Sussex-Neuroscience/screens-behavioural-box/README.md

# Screens behavioural box

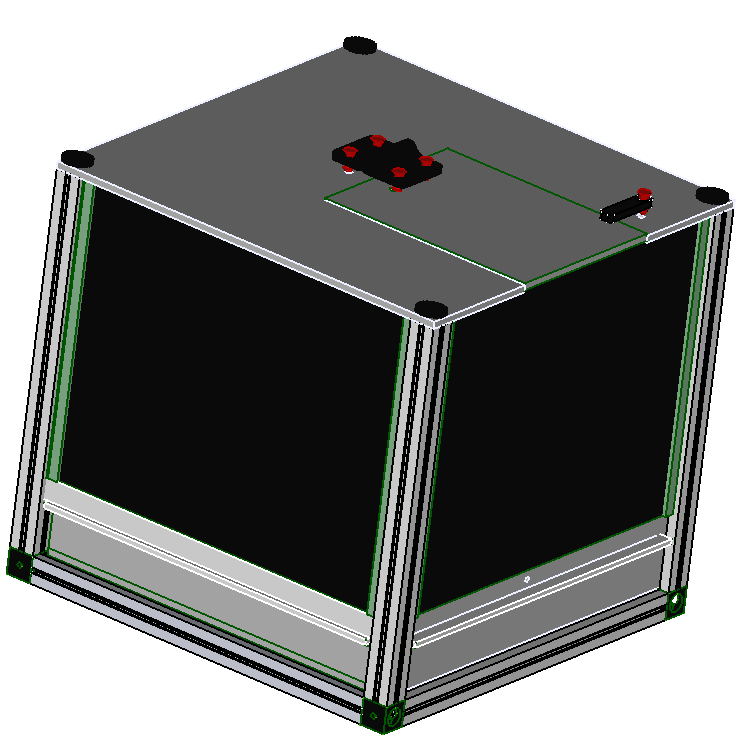
[picture p1: documentation/images/Final.PNG]


The box is used to research on mice reaction to different scenes played on the screens inside the box.

It uses an impliemtation of the beehive to check on the feeding of the mice.
