Sussex-Neuroscience/screens-behavioural-box/documentation/index.md

# Screens behavioural box



Free moving rodents complete viual field stimulation using touch screens.

It uses an impliemtation of the beehive to check on the feeding of the mice.

You should link to a couple of pages:

* [.](testpage1.md){step}
* [.](testpage2.md){step}

And you should definitely let people know about the [bill of materials]{BOM} page.
