Sussex-Neuroscience/screens-behavioural-box/documentation/Screens_behavioural_box.PNG

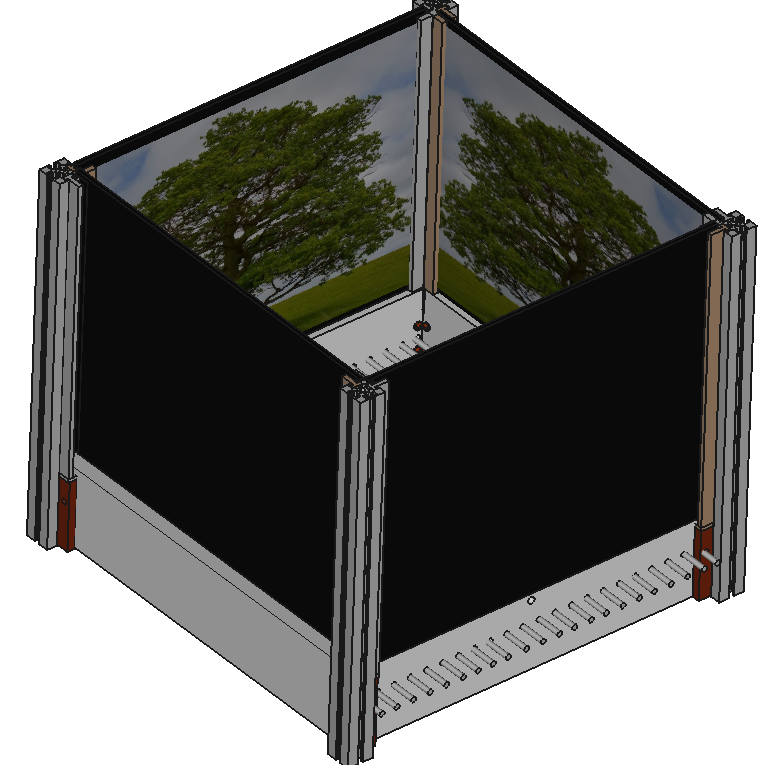
documentation/Screens_behavioural_box.PNG
