Sussex-Neuroscience/screens-behavioural-box/hardware/3mm_Aluminium_rod.FCStd

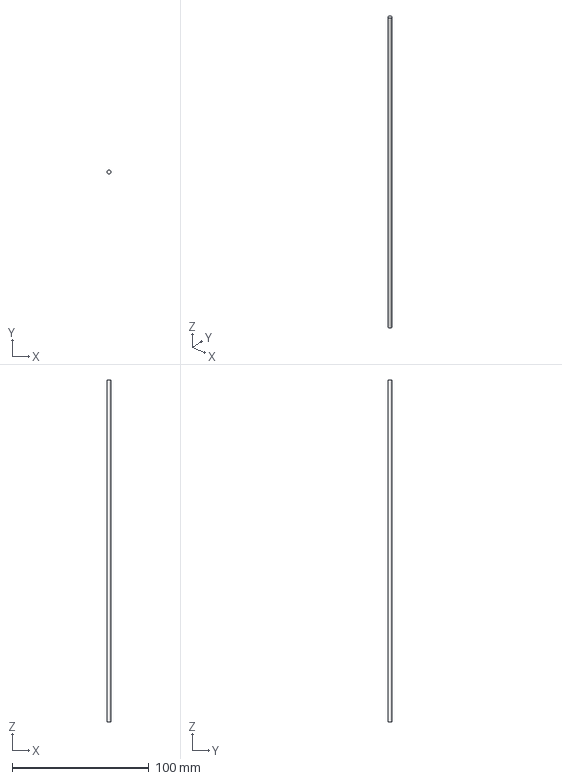
[picture p4: CAD file, 2024-06-05]
hardware/3mm_Aluminium_rod.FCStd
3.10 x 3.10 x 250.0 mm
