Sussex-Neuroscience/screens-behavioural-box/hardware/models/Screens_behavioural_box.FCStd

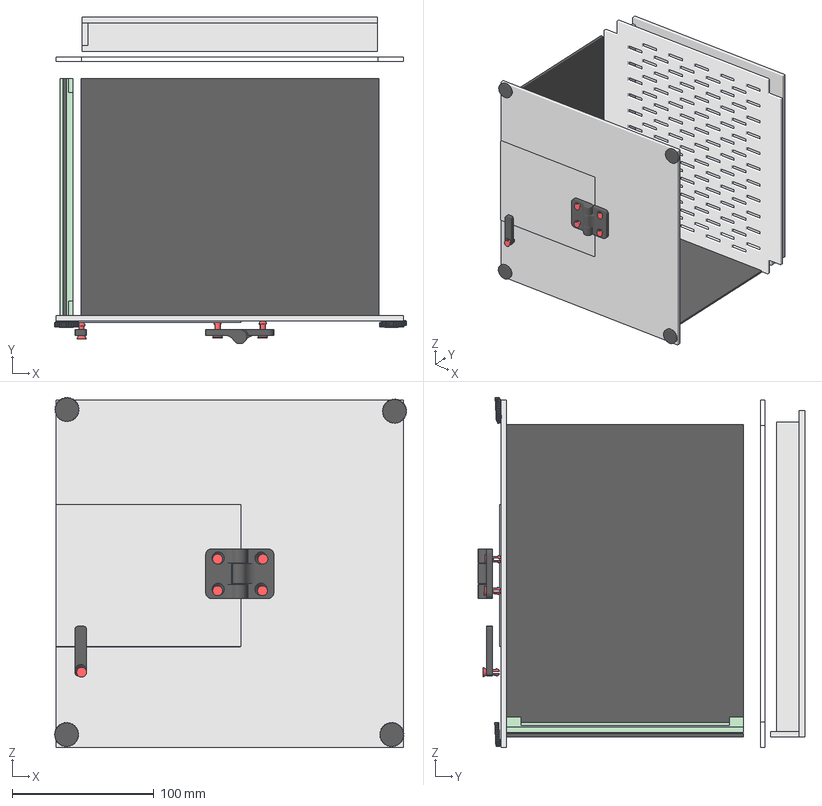
[picture p5: CAD file, 2024-08-22]
hardware/models/Screens_behavioural_box.FCStd
247.9 x 230.0 x 246.7 mm
Latch
Base
Excrete_bottom
Excretion_sides
Lid
Hinge_pin
Door
Hinge_pin001
Hinge_pin002
Hinge_pin003
Hinge_pin004
print-in-place-hinge
Thumb_wheel
Thumb_wheel001
Thumb_wheel002
Thumb_wheel003
