Sussex-Neuroscience/screens-behavioural-box/hardware/grid_bottom.stl

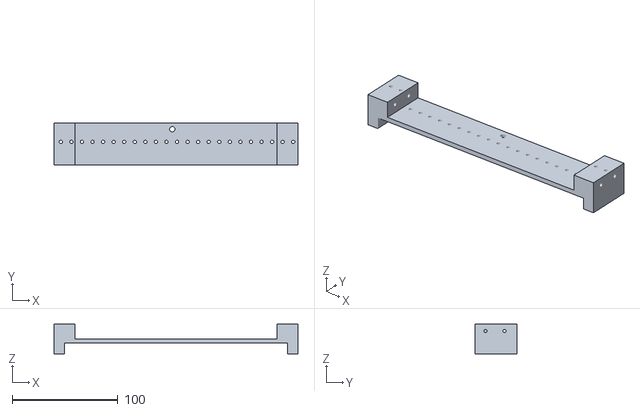
[picture p6: CAD file, 2024-05-12]
hardware/grid_bottom.stl
231.0 x 40.0 x 28.0
