Sussex-Neuroscience/screens-behavioural-box/hardware/models/Thumb_wheel.stl

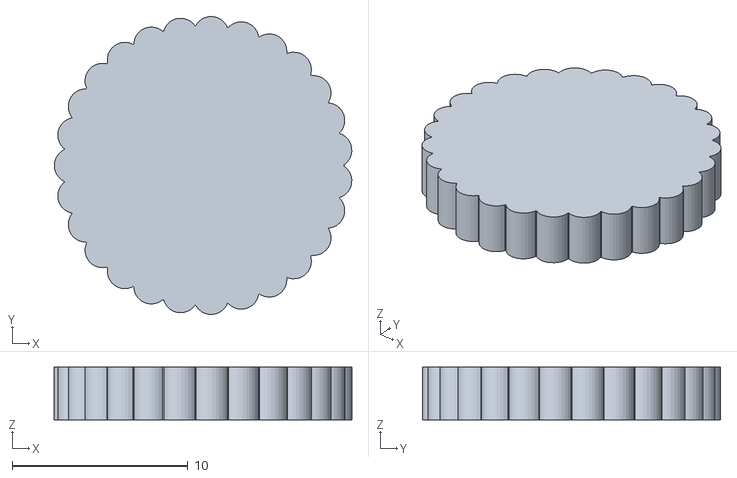
[picture p7: CAD file, 2024-07-31]
hardware/models/Thumb_wheel.stl
16.9 x 17.0 x 3.00
