Sussex-Neuroscience/screens-behavioural-box/hardware/models/Screen_support.stl

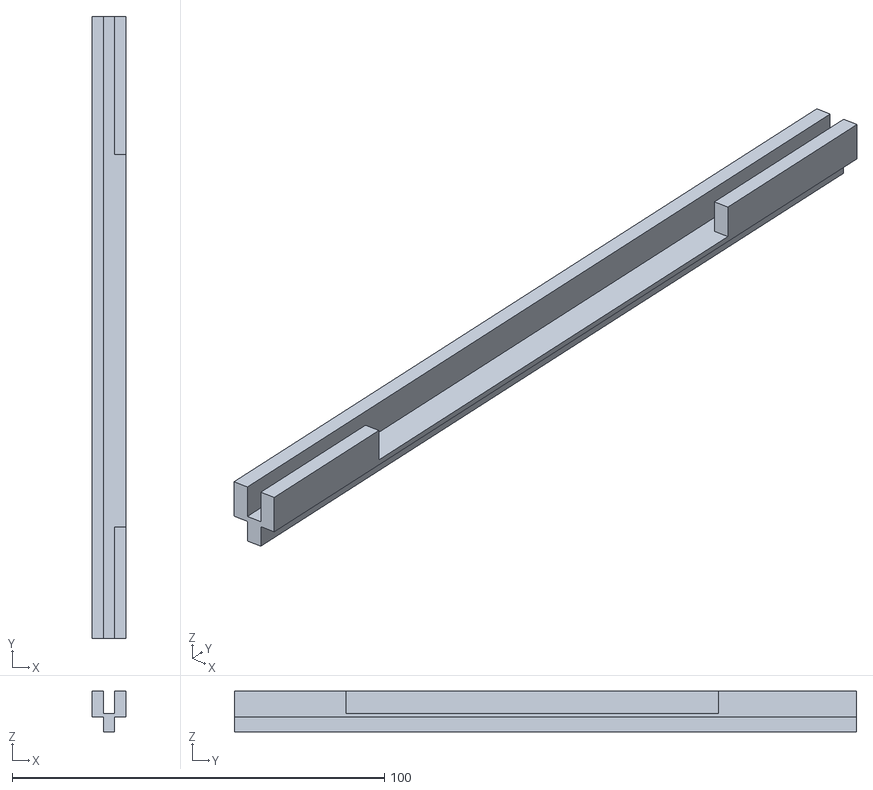
[picture p8: CAD file, 2024-07-31]
hardware/models/Screen_support.stl
9.00 x 167.0 x 11.0
