Sussex-Neuroscience/screens-behavioural-box/hardware/side_cover.stl

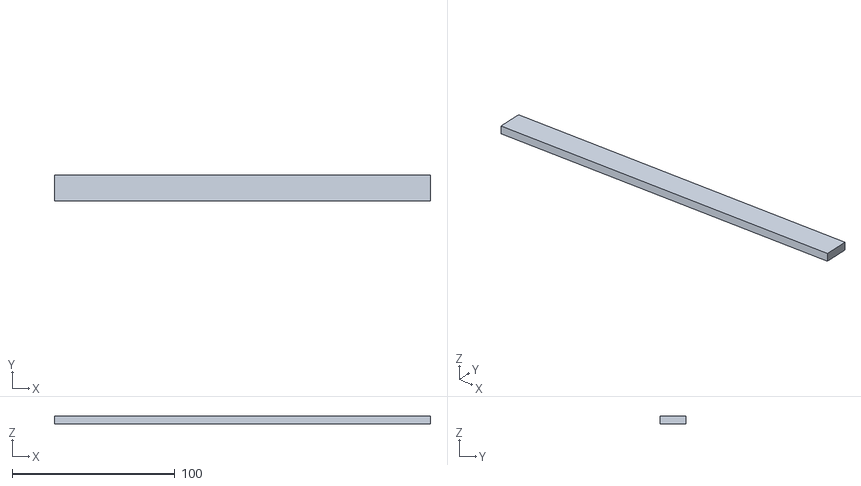
[picture p9: CAD file, 2024-05-12]
hardware/side_cover.stl
231.0 x 15.9 x 5.00
