Sussex-Neuroscience/screens-behavioural-box/hardware/models/Latch.stl

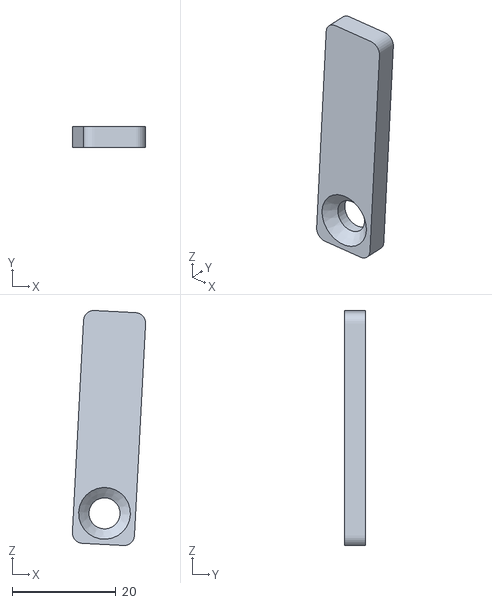
[picture p10: CAD file, 2024-07-31]
hardware/models/Latch.stl
14.1 x 4.00 x 45.4
