Sussex-Neuroscience/screens-behavioural-box/hardware/screen_holder.FCStd

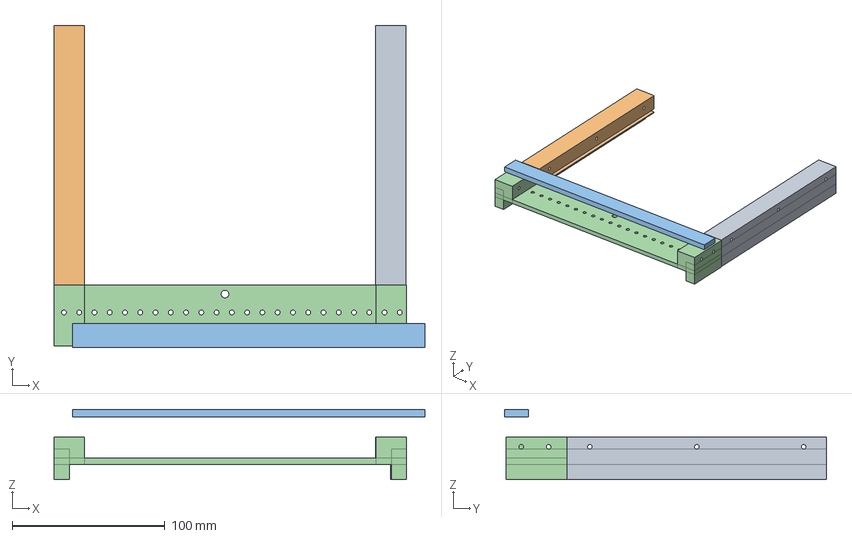
[picture p11: CAD file, 2024-05-12]
hardware/screen_holder.FCStd
243.0 x 211.0 x 46.0 mm
screenHolder (Mirror #1)
screenHolder001
side_cover
grid_bottom
