Sussex-Neuroscience/screens-behavioural-box/hardware/models/Groove_pin.stl

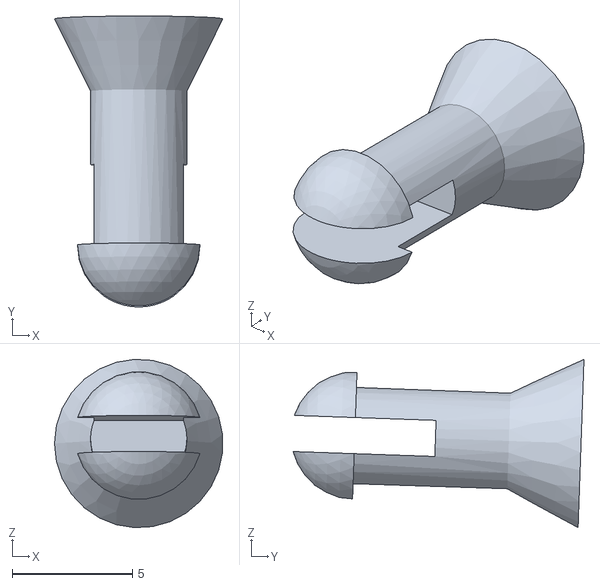
[picture p12: CAD file, 2024-07-31]
hardware/models/Groove_pin.stl
6.98 x 12.1 x 6.99
