Sussex-Neuroscience/screens-behavioural-box/hardware/screen_holder_mirrored.stl

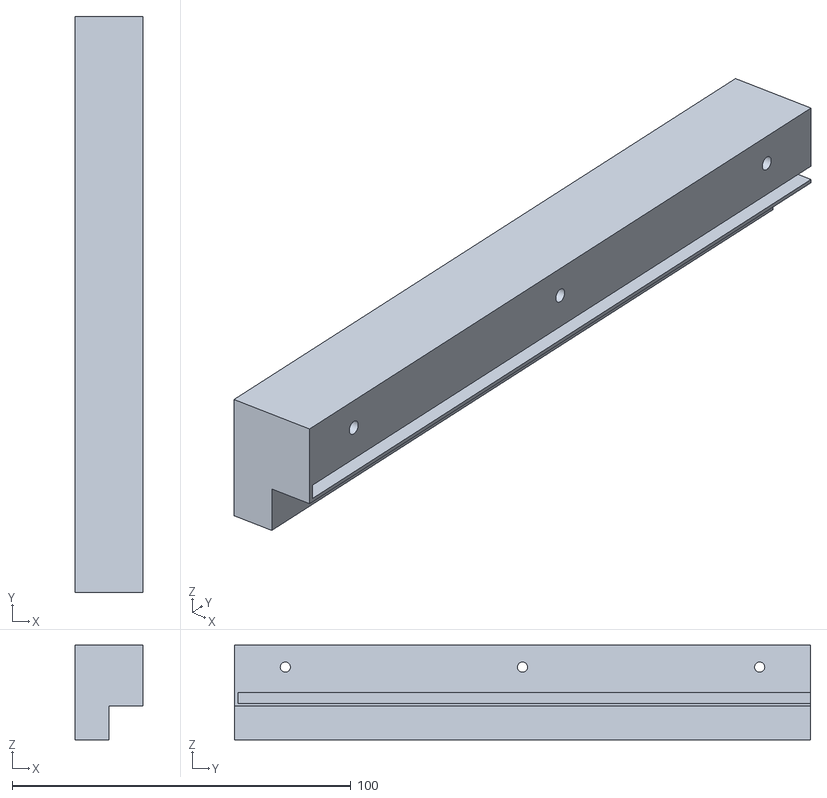
[picture p13: CAD file, 2024-05-12]
hardware/screen_holder_mirrored.stl
20.0 x 170.0 x 28.0
