Sussex-Neuroscience/screens-behavioural-box/hardware/models/Corners.step

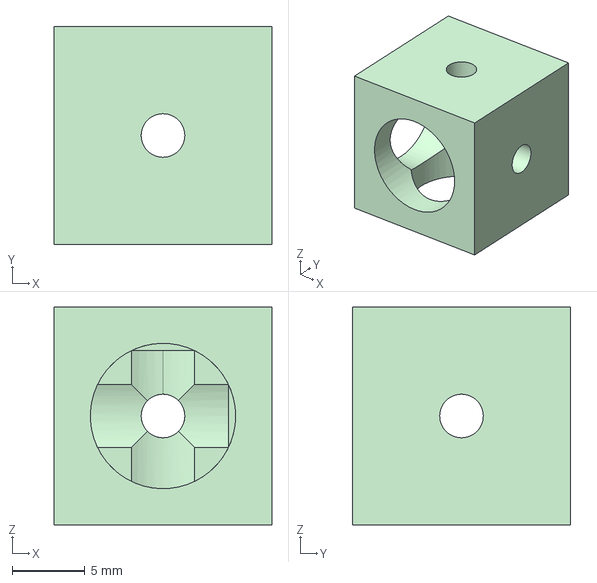
[picture p14: CAD file, 2024-07-31]
hardware/models/Corners.step
15.0 x 15.0 x 15.0 mm
