Sussex-Neuroscience/screens-behavioural-box/hardware/grid_template.stl

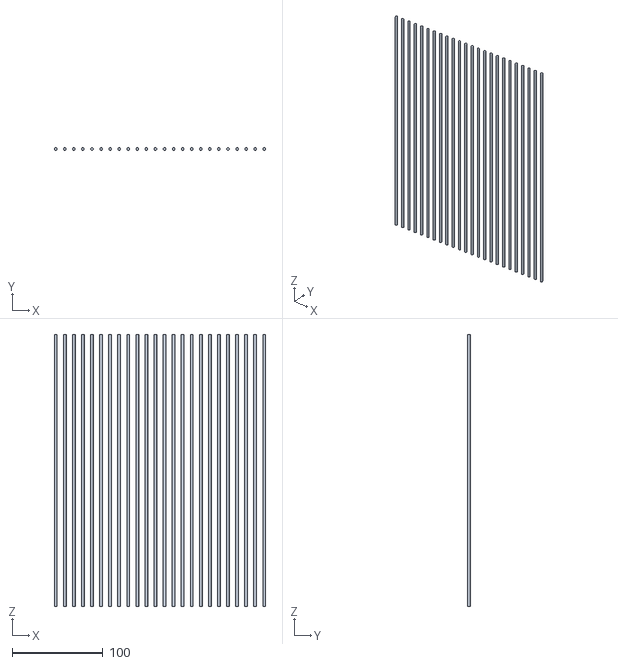
[picture p15: CAD file, 2023-11-29]
hardware/grid_template.stl
233.2 x 2.77 x 300.0
