Sussex-Neuroscience/screens-behavioural-box/(list of files, cad)

Other CAD files:
hardware/all_parts_P1S_printer.gcode.3mf
hardware/archive/all_parts_P1S_printer.gcode.3mf
hardware/models/Charlies_designs/Syringe Holder Model rev5.scad
hardware/archive/grid_with_support.scad
hardware/archive/screen_holder.stl
hardware/grid_with_support.scad
hardware/screen_holder.stl
