Sussex-Neuroscience/screens-behavioural-box/documentation/Parts.yaml

---
MakerBeamXL:
  Name: maker beam XL
  Description: >
    A single length of black anodised MakerBeamXL which has a 15mm x
    15mm square profile
  Suppliers:
    technobotsonline:
      PartNo: 4447-087
      Link: https://www.technobotsonline.com/makerbeamxl-1000mm-long-black-anodised-beam-threaded.html
Hacksaw:
  Name: 150mm mini hacksaw
  Description: >
    The Bahco Junior Hacksaws, featuring a steel frame and a fibreglass
    handle,  come with a practical and simple blade tensioning device.  The
    blade tensioning is easily achieved through a simple screw operation.
  Suppliers:
    RS:
      PartNo: 281-9162
      Link: https://uk.rs-online.com/web/p/hand-saws/2819162?gb=a
ClearSheet:
  Name: clear plastic sheet
  Description: >
    The polyethylene terephthalate glycol (PETG) sheet is both
    versatile and durable.  It can withstand high-impact knocks and drops, even
    at extremely low temperatures. resistant to chemicals and has a UL 94
    flammability rating, so it will  self-extinguish in the event of a fire.
  Suppliers:
    RS:
      PartNo: 334-6472
      Link: https://uk.rs-online.com/web/p/plastic-sheets/3346472?gb=s
M3X8mmSocketcap:
  Name: M3x8 socket cap screw
  Description: >
    Socket screws are a type of threaded bolt which screws into an
    appropriate socket,  and are used to fasten various materials
    together.  They are designed to be turned by hex keys or similar tools.
  Specs:
    Head: Hex Socket Cap
    Length: 8 mm
    Material: Stainless Steel
    Pitch: 0.5 mm
  Suppliers:
    RS:
      PartNo: 280-997
      Link: https://uk.rs-online.com/web/p/socket-screws/0280997?gb=s
2mmHexkey:
  Name: 2mm Hex key
  Description: >
    T handle tool is designed for very high torque speeds and offers an
    easy,  fantastic solution for loosening and tightening screws.
  Specs:
    Head: Hex key
    size: 2 mm
    Material: Chrome Vanadium Steel
    Arm: long
  Suppliers:
    RS:
      PartNo: 707-3282
      Link: https://uk.rs-online.com/web/p/hex-keys/7073282?gb=s
Tapwrench:
  Name: tap wrench
  Description: >
    Tap wrenches are a type of hand tool designed to tap internal
    thread tools with ease.  They are often equipped with adjustable jaws that
    secure to the fitting and handles  that allow the user to turn the tool with
    ease.
  Specs:
    Type: T-Handle Tap Wrench
    Material: Steel
    Thread size: M1.5 to M4
  Suppliers:
    RS:
      PartNo: 230-0112
      Link: https://uk.rs-online.com/web/p/tap-die-wrenches/2300112?gb=a
M3tapset:
  Name: M3 tap set
  Description: >
    Used for thread cutting in holes into various materials such as
    steel allowing you to create  a smooth and precise thread for bolts and
    other materials. 
  Specs:
    Type: Threading Tap Set
    Material: HSS
    Thread size: M3
  Suppliers:
    RS:
      PartNo: 215-552
      Link: https://uk.rs-online.com/web/p/threading-taps/0215552?gb=s
Lasercutter:
  Name: Laser cutter
  Description: |
    Glowforge 
  Specs:
    Technology: 45w laser
    Model: Glowforge PRO
    Dimensions: 38” (W) x 20 3/4” (D) x 8 1/4” (H)
  Suppliers:
    RS:
      PartNo: ENDER-3 S1 PRO
      Link: https://uk.rs-online.com/web/p/3d-printers/2857472?gb=s
3dprinter:
  Name: 3d printer
  Description: |
    CREALITY ENDER-3 S1 PRO 3D Printer Kit.
  Specs:
    Technology: FFF
    Build volume: 220x220x270
    Model: ENDER-3 S1 PRO
    Dimensions: 455 x 490 x 625mm
  Suppliers:
    RS:
      PartNo: ENDER-3 S1 PRO
      Link: https://uk.rs-online.com/web/p/3d-printers/2857472?gb=s
Display:
  Name: 3/4 retina display
  Description: |
    LG LP097QX1 - iPad 3/4 Retina Display
  Specs:
    Resolution: 2048x1536
    Size: 206mm x 165mm / 8.1" x 6.5"
    Weight: 130g
  Suppliers:
    RS:
      PartNo: 1751
      Link: https://www.adafruit.com/product/1751#technical-details
Displaydriver:
  Name: Display driver
  Description: |
    Qualia Bare Driver Board for LP097QX1 Display
  Specs:
    Dimensions: 45mm x 85mm / 1.8" x 3.4"
    Mounting Holes Distance: 37mm x 77mm / 1.5" x 3"
    Weight: 21g
  Suppliers:
    RS:
      PartNo: 1716
      Link: https://www.adafruit.com/product/1716
PLAfilament:
  Name: PLA filament
  Description: >
    Its polylactic acid (PLA) material gives your printed objects a
    high-quality surface finish.
     It's also ideal for beginners as it's easy to use.
  Specs:
    Colour: black
    Diameter: 1.75 mm
    Material: Polylactic acid (PLA)
    Weight: 300g
  Suppliers:
    RS:
      PartNo: 832-0214
      Link: https://uk.rs-online.com/web/p/3d-printing-materials/8320214?gb=s
vice:
  Name: Multi Angle Vice
  Description: >
    The large C-clamp mount allows for installation to a variety of
    surfaces including workbenches and tables.  This Multi-Angle Vice is an
    ideal tool for a wide range of trade, DIY, craft & hobby applications.
  Specs:
    Type: Multi Angle Vice
    Openning: 70 mm
  Suppliers:
    RS:
      PartNo: 1-83-069
      Link: https://uk.rs-online.com/web/p/vices/6677189?gb=s
Adhesive:
  Name: Liquid Adhesive
  Description: >
    This quick set two-part epoxy adhesive comes in two tubes for an
    easy and clean application.  This high strength and high performance
    adhesive can be used with most materials such as;  glass, wood, metals and
    plastics.
  Specs:
    Type: Epoxy Adhesive
    color: Transparent
    size: 24ml
    Setting time: 24h
  Suppliers:
    RS:
      PartNo: 132-605
      Link: https://uk.rs-online.com/web/p/adhesives/0132605?gb=a
cable:
  Name: Display cable
  Description: >
    This cable provides a seamless connection to support
    ultra-high-definition (UHD) videos.  This means you're assured clear,
    blur-free images and video.
  Specs:
    Type: male port
    version: 1.4
    size: 3m
    Resolution: 8k
  Suppliers:
    RS:
      PartNo: 195-4910
      Link: https://uk.rs-online.com/web/p/displayport-cables/1954910?gb=a
Adapter:
  Name: Adapter 9V dc Output
  Description: >
    These highly reliable power supplies have output voltages from 5.0
    V to 12.0 V and  all feature a Class II construction.The range, which is
    available in both barrel  jack and USB versions, also attributes universal
    input and fixed mains connectors.
  Specs:
    Type: plug-type G
    Output v: 9V dc
    Output I: 550mA
    Power: 5W
  Suppliers:
    RS:
      PartNo: 121-7130
      Link: https://uk.rs-online.com/web/p/ac-dc-adapters/1217130?gb=s
tape:
  Name: Black Hook & Loop Tape
  Description: |
    Velcro tape with adhesive on one side
  Specs:
    Width: 50mm
    Length: 5m
    Type: hook & loop
    Color: black
  Suppliers:
    RS:
      PartNo: 196-1279
      Link: https://uk.rs-online.com/web/p/hook-loop-tapes/1961279?gb=s
