Sussex-Neuroscience/screens-behavioural-box/(commit log)

2023-11-18 add hardware folder and readme
    [screen_holder.FCStd]
2023-11-18 better fitting for screens
    [grid.3mf, grid.scad, grid_with_support.scad, screen_holder-screenHolder.stl, screen_holder.FCStd]
2023-11-29 first prototype for the new cage
    [grid_bottom.3mf, grid_bottom.stl, grid_template.scad, grid_template.stl, screen_holder-screenHolder.stl, screen_holder.3mf, screen_holder.FCStd, screen_holder_mirrored.3mf]
2023-12-01 adjustments to screw hole placements and wall level
    [grid_bottom.stl, screen_holder.FCStd]
2024-05-12 update hardware files, stls, freecad, 3mf
    [all_parts_P1S_printer.gcode.3mf, grid.3mf, grid_bottom.3mf, grid_bottom.stl, screen_holder-screenHolder.stl, screen_holder.3mf, screen_holder.FCStd, screen_holder.stl]
2024-06-05 updates as of 05/06/2024
    [15mm_aluminium_profile_channel.FCStd, 3mm_Aluminium_rod.FCStd, Bottom_partitions.FCStd, Bottom_partitions.dxf, Bottom_partitions_no_rods.FCStd, Bottom_slider.FCStd, Bottom_slider.step, Bottom_slider_mirror.FCStd]
2024-07-31 git building addition
    [15mm_aluminium_profile_channel.FCStd, All parts.stl, Bottom_partitions.FCStd, Bottom_partitions.dxf, Bottom_partitions_no_rods.FCStd, Bottom_slider.FCStd, Bottom_slider.step, Bottom_slider_mirror.FCStd]
2024-08-22 updated documentation
    [Allparts.stl, Corners.step, Groove_pin.stl, Latch.stl, Screen_support.stl, Screens_behavioural_box.FCStd, Thumb_wheel.stl]
2024-08-22 reorganise repo for GH-pages and generate html
    [3mm_Aluminium_rod.FCStd, Allparts.stl, Corners.step, Groove_pin.stl, Latch.stl, Screen_support.stl, Screens_behavioural_box.FCStd, Thumb_wheel.stl]
2024-08-22 more info on box
    [Screens_behavioural_box.FCStd]
2024-11-14 included charlies designs
    [ComponentBox.scad, Needle housing rev3.scad, Screens_behavioural_box.FCStd, SolenoidHold rev2.scad, Syringe Holder Model rev5.scad, SyringeCap.scad]
2024-11-14 add arduino routine for bonsai control
2025-04-23 Add files via upload
    Added valveControl.py which links the touch sensors to the valves.
